jing-yv666/XiangMu1/(list of files, cad)

Other CAD files:
低速轴_A2_1：1.dwg
装配图_A0_1：1.dwg
低速大齿轮_A2_1：1.5.dwg
装配图_A0_1：1.5.dwg
