jing-yv666/XiangMu1/装配图_A0_1：1.pdf

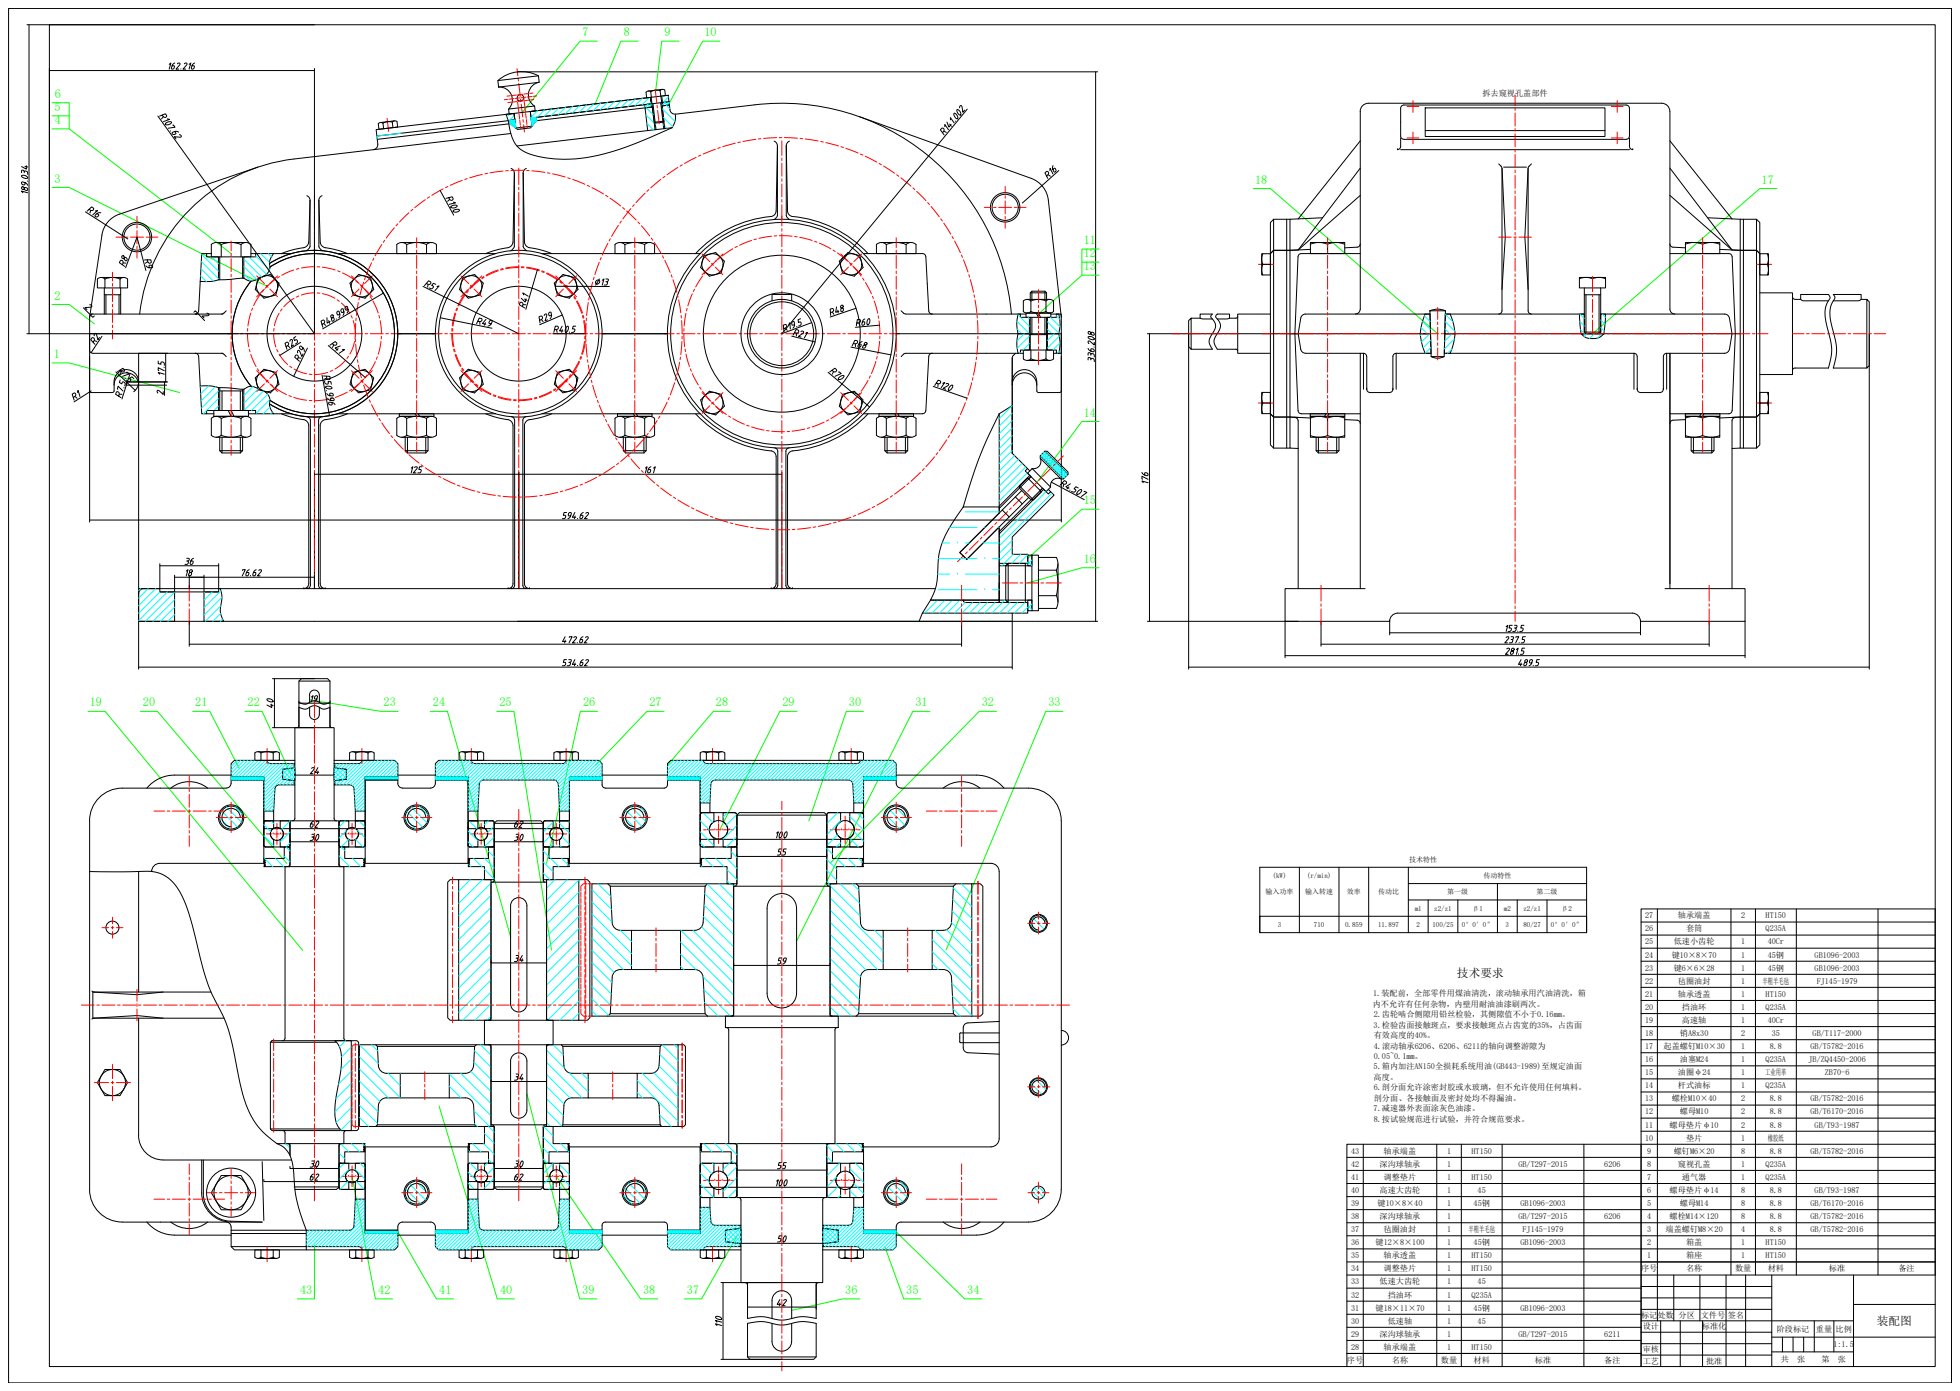
[picture p13: page 1]
17 拆去窥视孔盖部件 19; 端盖螺钉M8×20; 螺栓M14×120; 螺母M14; 螺母垫片φ14; 通气器; 窥视孔盖; 螺钉M6×20; 橡胶纸 11; 螺母垫片φ10; 螺母M10; 螺栓M10×40; 杆式油标; 油圈φ24; 工业用革; 油塞M24; 起盖螺钉M10×30; 高速轴; 挡油环; 轴承透盖; 毡圈油封; 半粗羊毛毡; 低速小齿轮; 轴承端盖; 深沟球轴承; 低速轴; 低速大齿轮; 调整垫片; 高速大齿轮; 装配图 阶段标记; 第 张 审核设计; 标准化 标记处数; 文件号 签名; 输入转速 (r/min) 710; 传动比 11.897; 传动特性 第一级; 第二级 m12; β2 0°0′0″ 技术特性
